ZYFXzz/Digital-Electronics_Final_Project_miniLab/V2_Presentation_Capstone.pdf

# TeensyLab V2

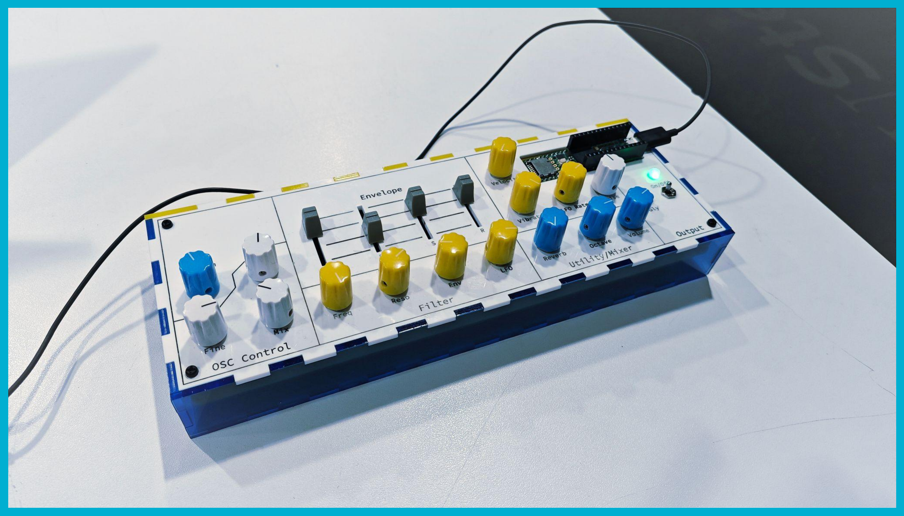
[picture p67: figure]

Building a Digital Guitar-to-Synth System Using Max, JUCE and Teensy

Michael Xie, Spring 2024 Capstone Presentation

Advisor: Prof. Steven Litt & Prof. Paul Geluso

# Introduction

- Goal: Using the tools learned, build a system mimic the guitar-to-synth pedals. The first inspiration is MIKU KORG, a guitar-to-vocal pedal.
- Miku Korg, Mooer E7, BOSS SY-1

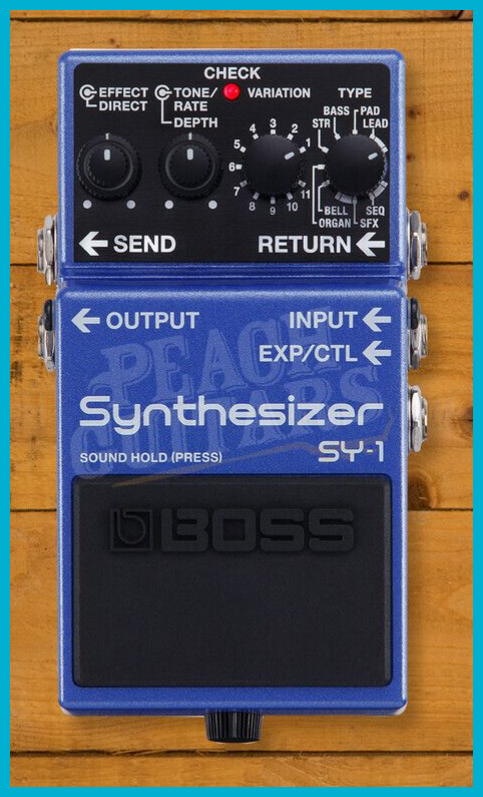
[picture p68: figure]
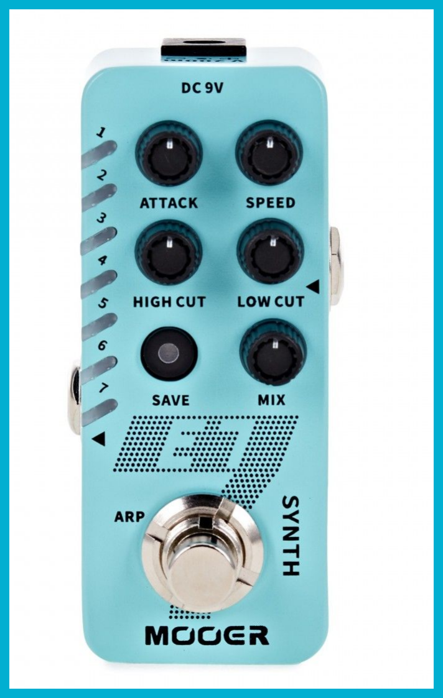
[picture p69: figure]
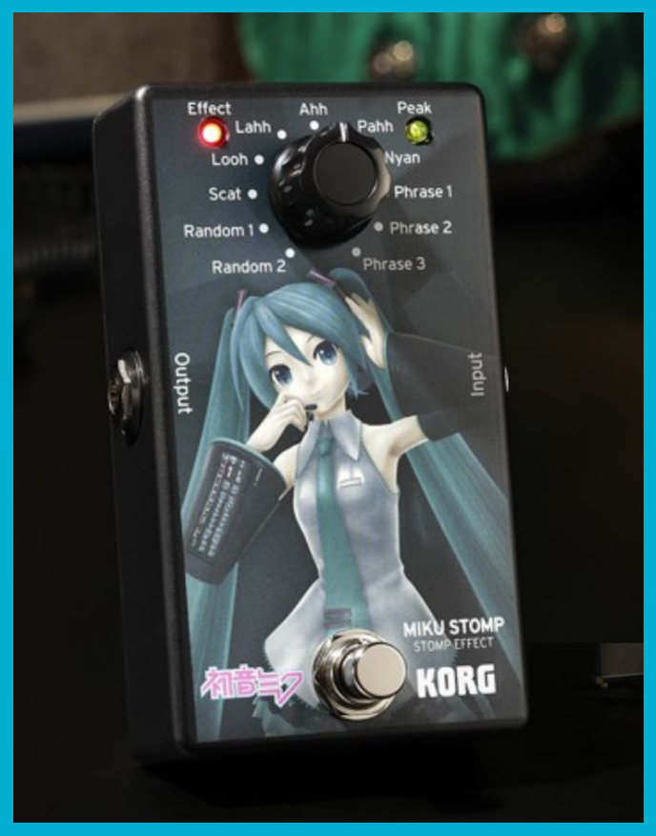
[picture p70: figure]

# Introduction

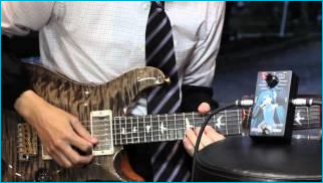
[picture p71: figure]

# Introduction

- Method A: F0 detection/estimation -> midi event. YIN algorithm based on autocorrelation method.
- Method B: Transformation in the frequency domain.

# Project Description

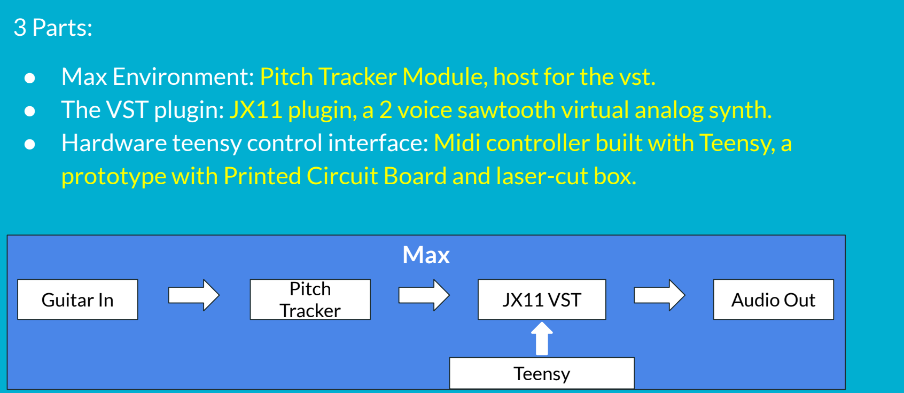
[picture p72: figure]
3 Parts:; Max; Pitch; Tracker; JX11 VST; Teensy; Guitar In; Audio Out

- Max Environment: Pitch Tracker Module, host for the vst.
- The VST plugin: JX11 plugin, a 2 voice sawtooth virtual analog synth.
- Hardware teensy control interface: Midi controller built with Teensy, a prototype with Printed Circuit Board and laser-cut box.

# Max Environment

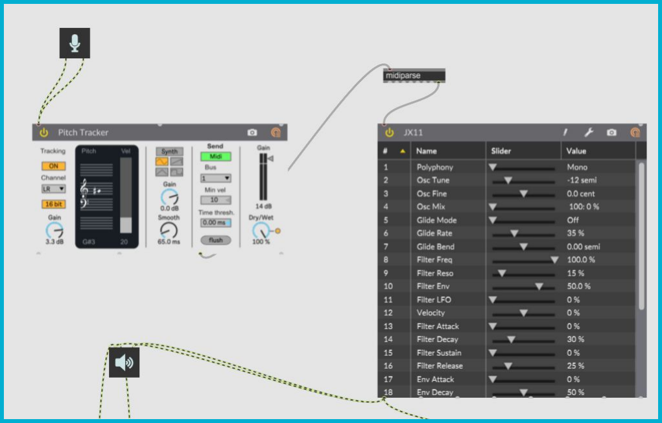
[picture p73: figure]

# The JX11 VST Plugin

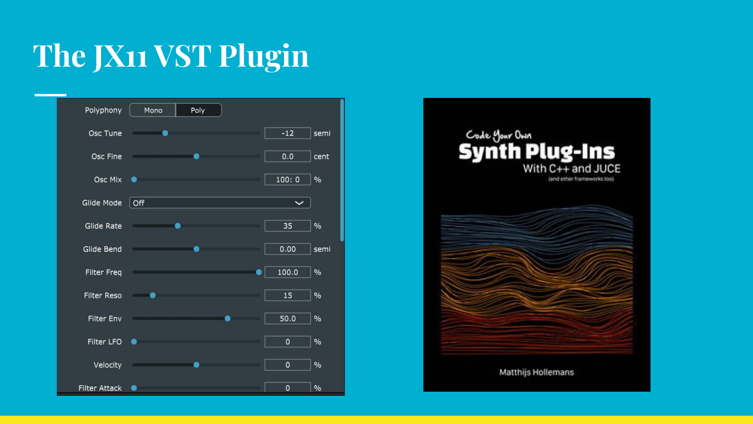
[picture p74: page 7]

# The JX11 VST Plugin

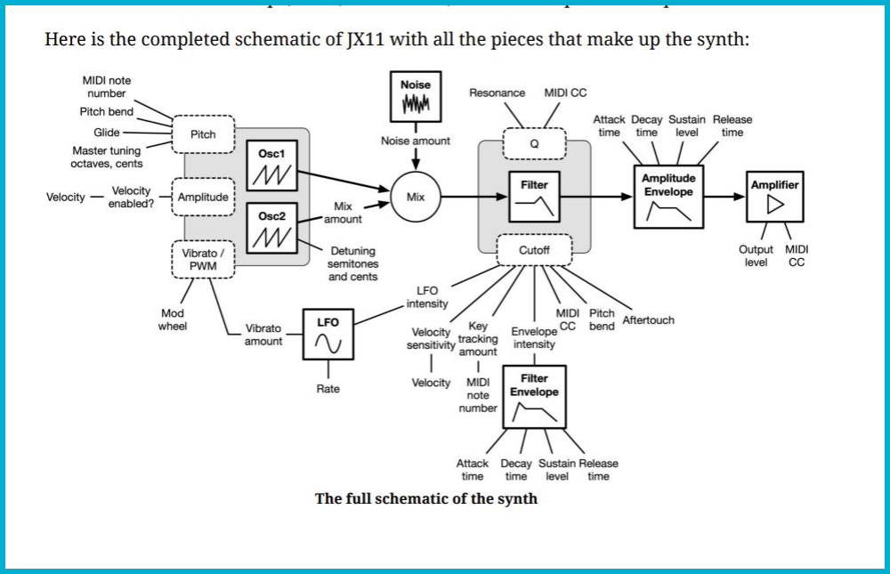
[picture p75: figure]

# Control Interface with Teensy

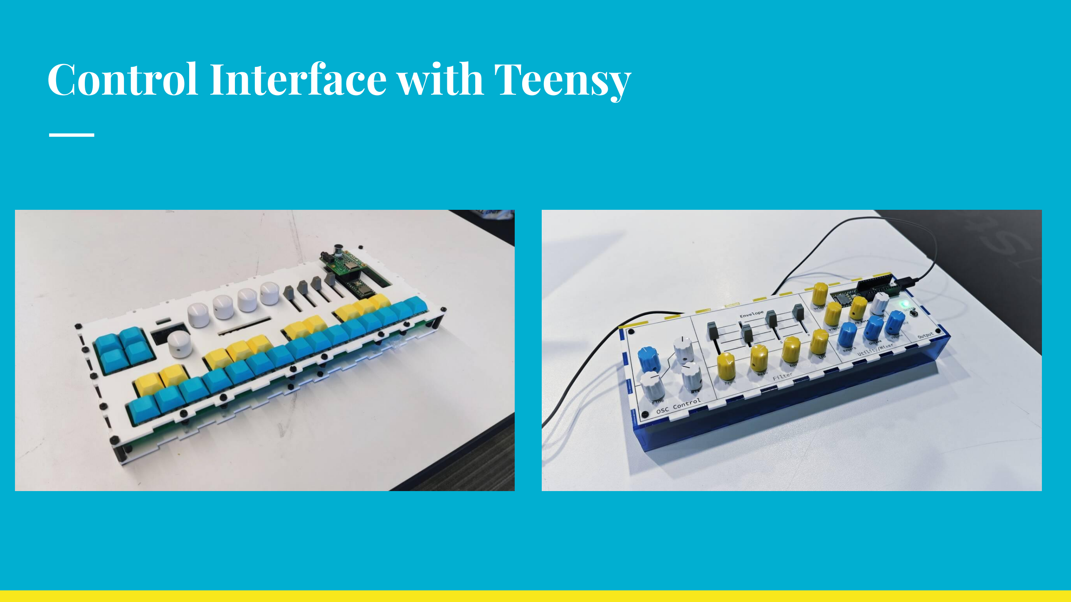
[picture p76: page 9]

# Control Interface with Teensy

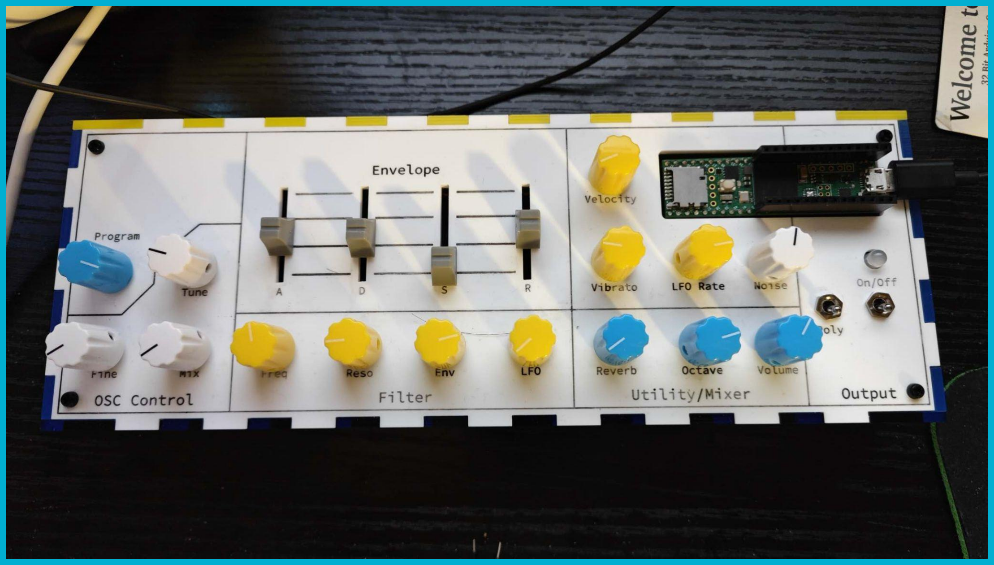
[picture p77: figure]

- Encoder * 1
- Potentiometer * 18
- 2 Switches
- Neopixel LED

# Control Interface with Teensy

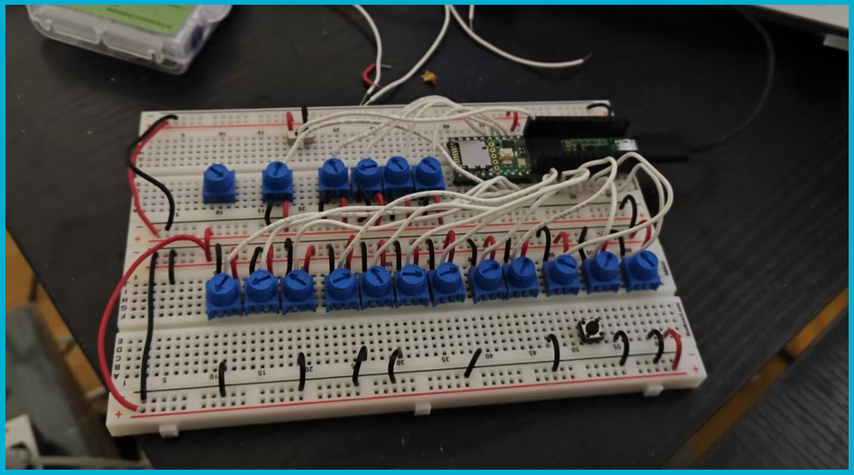
[picture p78: figure]

- Encoder * 1
- Potentiometer * 18
- 2 Switches
- Neopixel LED

# Control Interface with Teensy

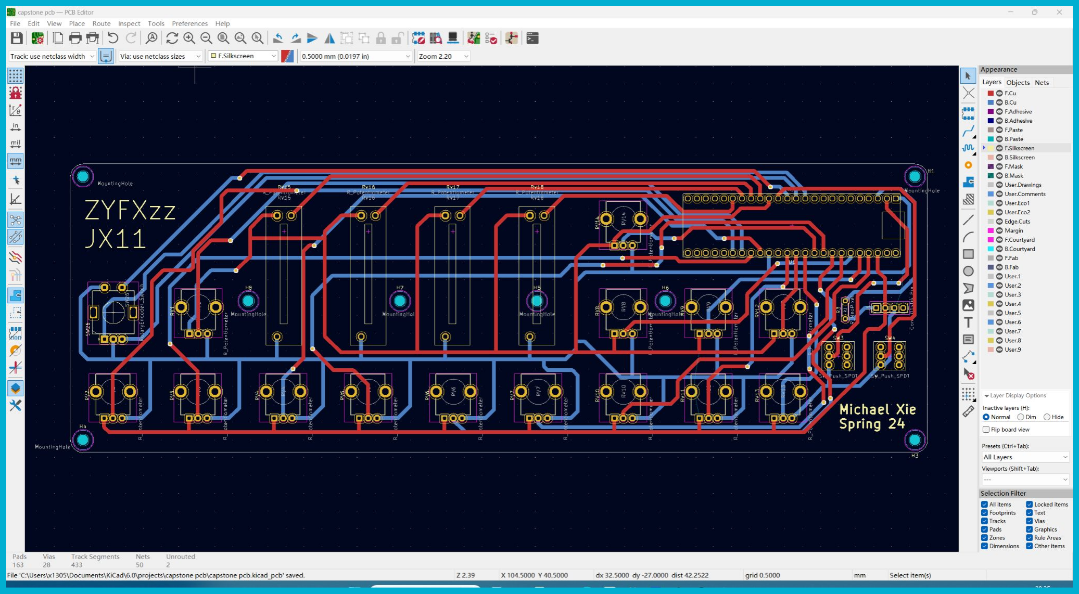
[picture p79: figure]

- Encoder * 1
- Potentiometer * 18
- 2 Switches
- Neopixel LED

# Control Interface with Teensy

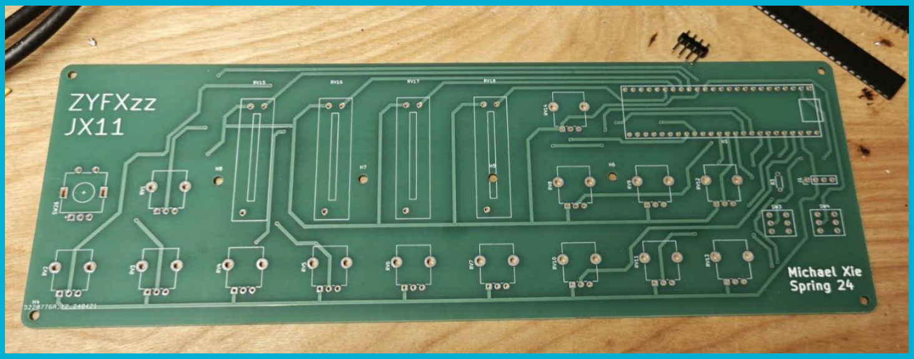
[picture p80: figure]

- Encoder * 1
- Potentiometer * 18
- 2 Switches
- Neopixel LED

# Control Interface with Teensy

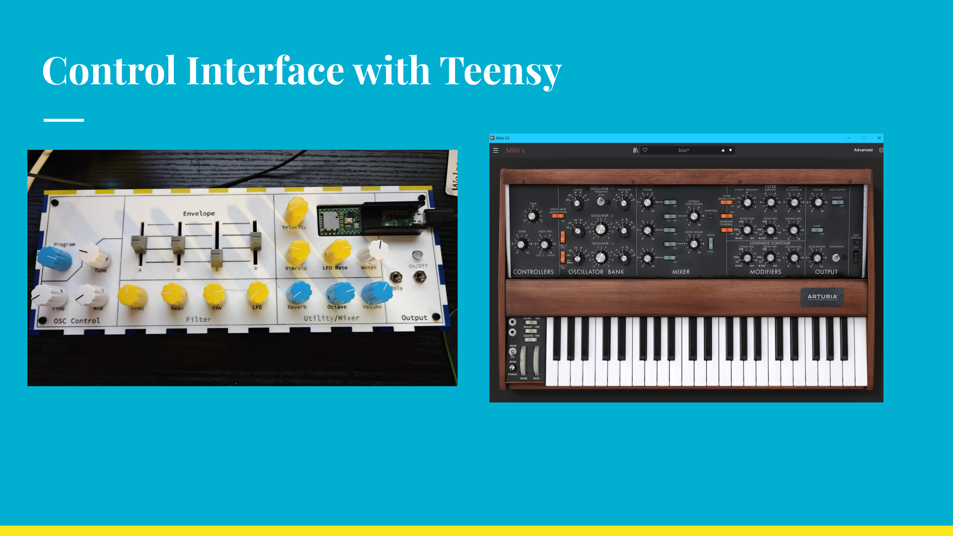
[picture p81: page 14]

# Control Interface with Teensy

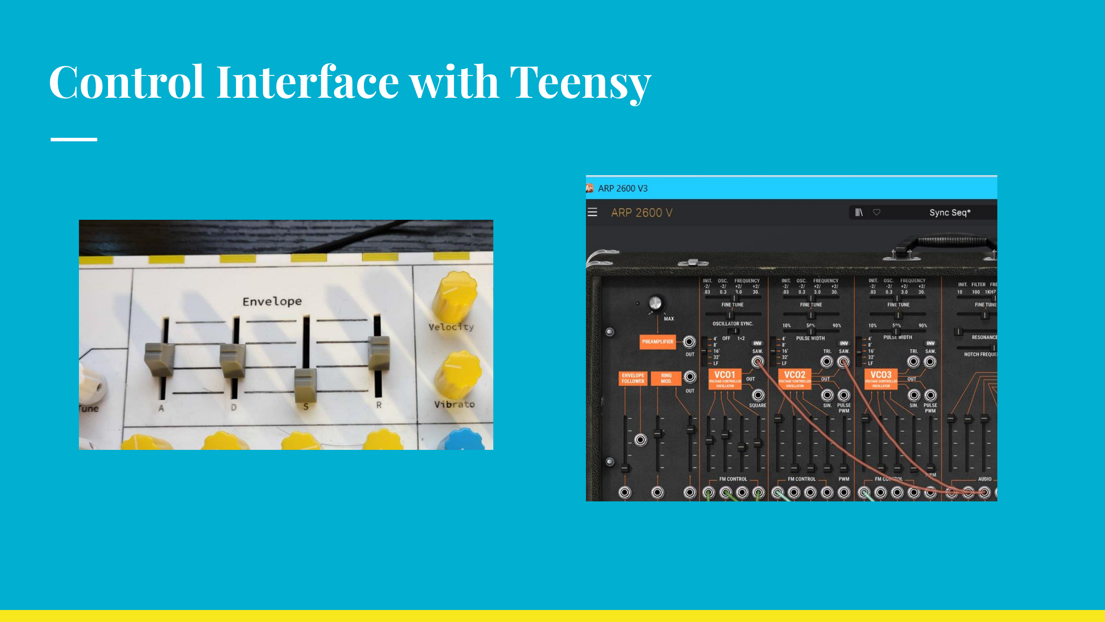
[picture p82: page 15]

# Demo

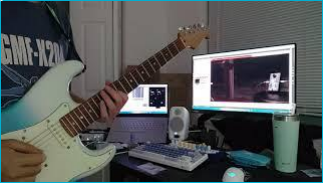
[picture p83: figure]

# Future Work

- Add sample-based synthesis, which was expected to accomplish when proposing the project.
- Improve pitch tracking: using other tools available, midi debounce mechanism, distinguish between a new note event and vibrato/pitch bending.
- Expand max patch, put in midi effects. A note in, a chord out.
- Machine Learning Timbre transfer, DDSP from Google Magenta. With ML, DDSP can transform bird singing to violin playing.

# Conclusion

- A better understanding of structure/life-cycle of an audio plugin
- A continue practice of electronics
- A good summary of my study in the undergrad program
- A stepping stone for future work in the master

# Thank you!

# Reference

Alain de Cheveigne, and Hideki Kawahara. “Yin, a Fundamental Frequency Estimator for Speech and Music.” Http://Audition.Ens.Fr/Adc/Pdf/2002_JASA_YIN.Pdf, audition.ens.fr/adc/pdf/2002_JASA_YIN.pdf. Accessed 11 Dec. 2023.

Roads, Curtis. The Computer Music Tutorial. The MIT Press, 2023.

Hollemans, Matthijs. Code Your Own Synth Plug-Ins with C++ and JUCE. Independently Published, 2023.

Pirkle, William C. Designing Audio Effect Plugins in C++: For AAX, AU, and VST3 with DSP Theory. Routledge, 2019.
