ZYFXzz/Digital-Electronics_Final_Project_miniLab/Teensy Lab V1.jpeg

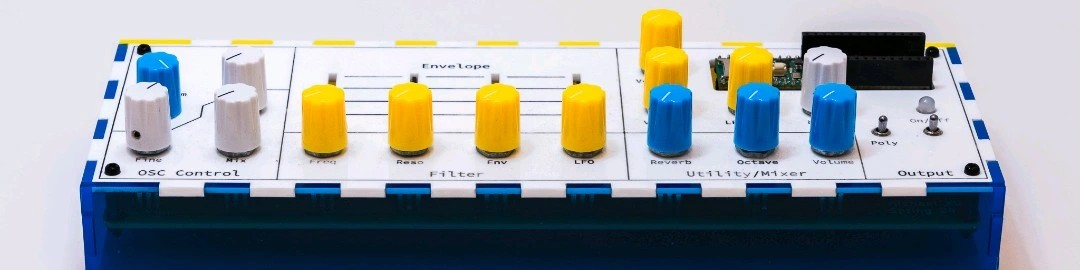
Teensy Lab V1.jpeg
