ZYFXzz/Digital-Electronics_Final_Project_miniLab/Final_Project_miniLab_moreStepDrumSequencer_May4th_FinalVersion/Stepper.h

#ifndef Stepper_h
#define Stepper_h

#include "Arduino.h"

class Stepper {
public:
  Stepper(int _numSteps, int _timePerStep);
  void process();
  void nextStep();
  void stepHandler(void (*f)(int));
  void (*stepCallback)(int);
  void setTimePerStep(int _timePerStep);
  void stepReset();
  void stepChange(int _newStepNumber);

  int numSteps;
  int currentStep;
  int timePerStep;
  unsigned long lastStepTime;
};

#endif
