ZYFXzz/Digital-Electronics_Final_Project_miniLab/(commit log)

2023-04-02 added a encoder, working properly
2023-04-02 testing interrupt() with a button
2023-04-06 project update on April 6th
    add bunch of header files from Steve,
    got 1 encoder, 1 button, 2 optional key switches tested, working properly
2023-04-10 April 9th update
    put everything together
    added stepper class for timed control
2025-10-13 Rename 076BFD4137BC595DC9F082E58C427191.jpg to TeensyLab V2.jpg
2025-10-13 Rename 1734674557080.jpeg to Teensy Lab V1.jpeg
2025-10-13 Rename Teensy Lab V1.jpeg to TeensyLab V1.jpeg
2025-10-13 Rename B922C17C4956137C3E607BDCABFF0A8F.jpg to TeensyLab V1.jpg
2025-10-13 Rename Digital Final Project Report.pdf to TeensyLab_V1_Digital_Final_Project_Report.pdf
